Auroxin/picoloader-hw/3d-print/picoloader-pcb-plug-20260901.step

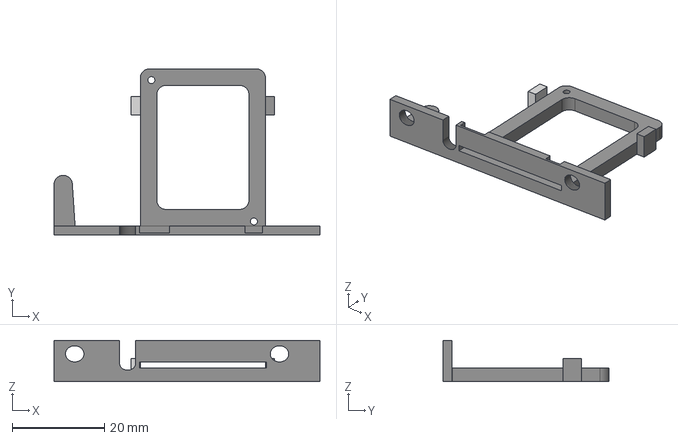
[picture p5: CAD file, 2026-10-19]
3d-print/picoloader-pcb-plug-20260901.step
57.8 x 36.1 x 9.00 mm
