Auroxin/picoloader-hw/3d-print/Fold_KeyV1.2.stl

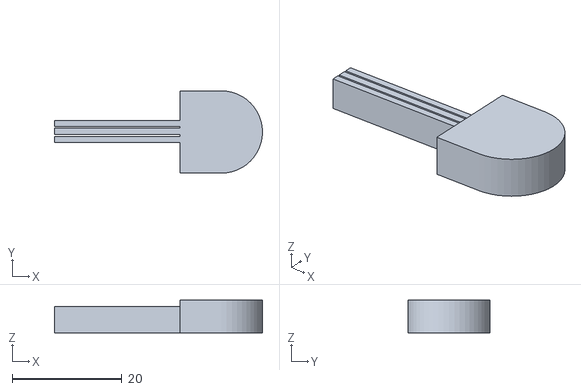
[picture p6: CAD file, 2026-10-19]
3d-print/Fold_KeyV1.2.stl
37.9 x 15.0 x 6.00
