Auroxin/picoloader-hw/3d-print/Drive_PlugV1.1.stl

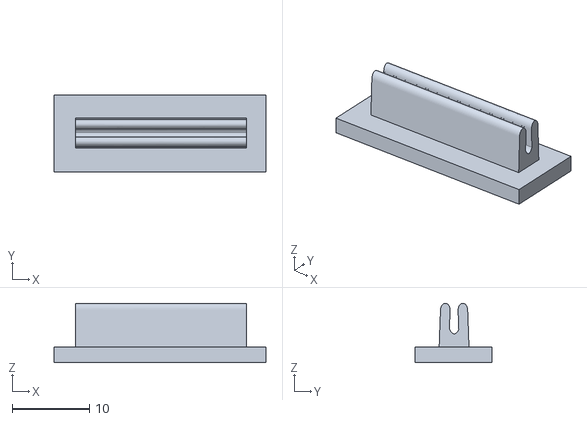
[picture p7: CAD file, 2026-10-19]
3d-print/Drive_PlugV1.1.stl
27.5 x 10.0 x 7.72
