Auroxin/picoloader-hw/hw/v1.1A/picoloader.kicad_pcb

## KiCad design hw/v1.1A/picoloader.kicad_pcb (2026-10-19)

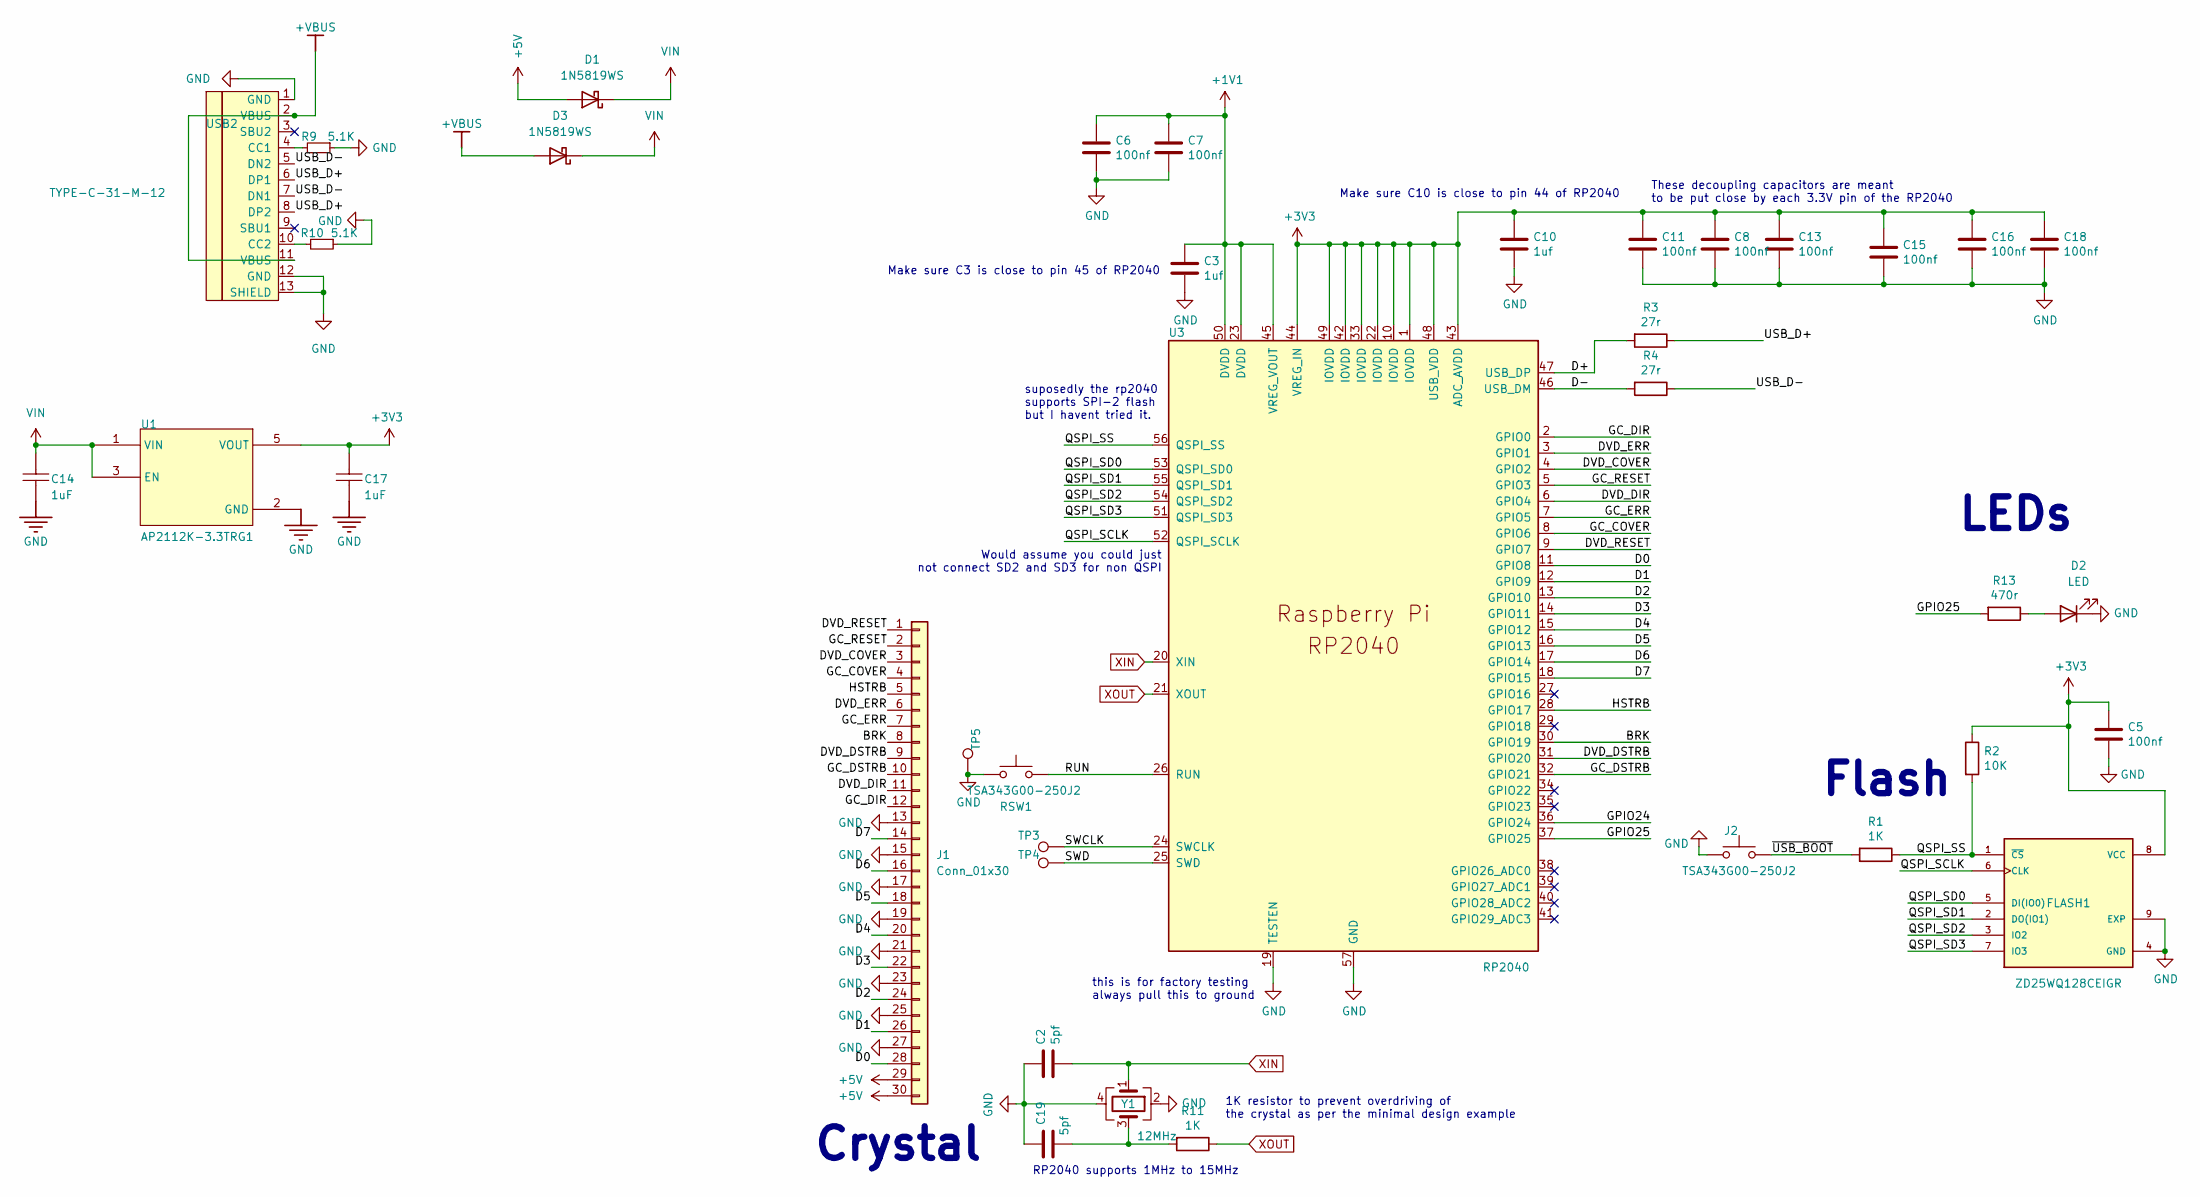
[picture p8: schematic picoloader.kicad_sch]

Parts:
C2, C19: 5pf; C_0402_1005Metric
C3, C10: 1uf; C_0603_1608Metric
C5, C6, C7, C8, C11, C13, C15, C16, C18: 100nf; C_0402_1005Metric
C14, C17: 1uF; C_0603_1608Metric; TOLERANCE 10%; VOLTAGE RATING 25V; MANUFACTURER PART NUMBER C1005X5R1E105K050BC
D1, D3: 1N5819WS; D_SOD-323
D2: LED; LED_0603_1608Metric
FLASH1: ZD25WQ128CEIGR; Winbond_USON-8-1EP_3x2mm_P0.5mm_EP0.2x1.6mm
J1: Conn_01x30; Hirose_FH12-30S-0.5SH_1x30-1MP_P0.50mm_Horizontal
J2: TSA343G00-250J2; SW_Push_SPST_NO_Alps_SKRK
R1, R11: 1K; R_0402_1005Metric
R2: 10K; R_0402_1005Metric
R3, R4: 27r; R_0402_1005Metric
R9, R10: 5.1K; R_0402_1005Metric
R13: 470r; R_0402_1005Metric
RSW1: TSA343G00-250J2; SW_Push_SPST_NO_Alps_SKRK
TP3, TP4, TP5: TestPoint; TestPoint_Pad_D1.0mm
U1: AP2112K-3.3TRG1; SOT-23-5; DROPOUT VOLTAGE 250mV; OUTPUT VOLTAGE 3.3V; MANUFACTURER PART NUMBER AP2112K-3.3TRG1
U3: RP2040; RP2040-QFN-56; LCSC C2040
USB2: TYPE-C-31-M-12; HRO-TYPE-C-31-M-12; LCSC C165948
Y1: 12MHz; Crystal_SMD_3225-4Pin_3.2x2.5mm

Connections:
+1V1: C3.1, C6.1, C7.1, U3.23 (DVDD), U3.45 (VREG_VOUT), U3.50 (DVDD)
+3V3: C5.1, C8.1, C10.1, C11.1, C13.1, C15.1, C16.1, C17.2, C18.1, FLASH1.8 (VCC), R2.1, U1.5 (VOUT), U3.1 (IOVDD), U3.10 (IOVDD), U3.22 (IOVDD), U3.33 (IOVDD), U3.42 (IOVDD), U3.43 (ADC_AVDD), U3.44 (VREG_IN), U3.48 (USB_VDD), U3.49 (IOVDD)
+5V: D1.2 (A), J1.29, J1.30
+VBUS: D3.2 (A), USB2.2 (VBUS), USB2.11 (VBUS)
/BRK: J1.8, U3.30 (GPIO19)
/D0: J1.28, U3.11 (GPIO8)
/D1: J1.26, U3.12 (GPIO9)
/D2: J1.24, U3.13 (GPIO10)
/D3: J1.22, U3.14 (GPIO11)
/D4: J1.20, U3.15 (GPIO12)
/D5: J1.18, U3.16 (GPIO13)
/D6: J1.16, U3.17 (GPIO14)
/D7: J1.14, U3.18 (GPIO15)
/D+: R3.2, U3.47 (USB_DP)
/D-: R4.2, U3.46 (USB_DM)
/DVD_COVER: J1.3, U3.4 (GPIO2)
/DVD_DIR: J1.11, U3.6 (GPIO4)
/DVD_DSTRB: J1.9, U3.31 (GPIO20)
/DVD_ERR: J1.6, U3.3 (GPIO1)
/DVD_RESET: J1.1, U3.9 (GPIO7)
/GC_COVER: J1.4, U3.8 (GPIO6)
/GC_DIR: J1.12, U3.2 (GPIO0)
/GC_DSTRB: J1.10, U3.32 (GPIO21)
/GC_ERR: J1.7, U3.7 (GPIO5)
/GC_RESET: J1.2, U3.5 (GPIO3)
/GPIO24: U3.36 (GPIO24)
/GPIO25: R13.2, U3.37 (GPIO25)
/HSTRB: J1.5, U3.28 (GPIO17)
/QSPI_SCLK: FLASH1.6 (CLK), U3.52 (QSPI_SCLK)
/QSPI_SD0: FLASH1.5 (DI(IO0)), U3.53 (QSPI_SD0)
/QSPI_SD1: FLASH1.2 (DO(IO1)), U3.55 (QSPI_SD1)
/QSPI_SD2: FLASH1.3 (IO2), U3.54 (QSPI_SD2)
/QSPI_SD3: FLASH1.7 (IO3), U3.51 (QSPI_SD3)
/QSPI_SS: FLASH1.1 (~CS), R1.1, R2.2, U3.56 (QSPI_SS)
/RUN: RSW1.2, U3.26 (RUN)
/SWCLK: TP3.1 (1_1), U3.24 (SWCLK)
/SWD: TP4.1 (1_1), U3.25 (SWD)
/USB_D+: R3.1, USB2.6 (DP1), USB2.8 (DP2)
/USB_D-: R4.1, USB2.5 (DN2), USB2.7 (DN1)
/~USB_BOOT: J2.1, R1.2
GND: C2.1, C3.2, C5.2, C6.2, C7.2, C8.2, C10.2, C11.2, C13.2, C14.1, C15.2, C16.2, C17.1, C18.2, C19.1, D2.1 (K), FLASH1.4 (GND), FLASH1.9 (EXP), J1.13, J1.15, J1.17, J1.19, J1.21, J1.23, J1.25, J1.27, J1.MP, J2.2, R9.1, R10.1, RSW1.1, TP5.1 (1_1), U1.2 (GND), U3.19 (TESTEN), U3.57 (GND), USB2.1 (GND), USB2.12 (GND), USB2.13 (SHIELD), Y1.2, Y1.4
unnamed: C19.2, R11.2, Y1.3
unnamed: D2.2 (A), R13.1
unnamed: R9.2, USB2.4 (CC1)
unnamed: R10.2, USB2.10 (CC2)
VIN: C14.2, D1.1 (K), D3.1 (K), U1.1 (VIN), U1.3 (EN)
XIN: C2.2, U3.20 (XIN), Y1.1
XOUT: R11.1, U3.21 (XOUT)

Notes on the sheet:
These decoupling capacitors are meant to be put close by each 3.3V pin of the RP2040
this is for factory testing always pull this to ground
suposedly the rp2040 supports SPI-2 flash but I havent tried it.
1K resistor to prevent overdriving of the crystal as per the minimal design example
LEDs
Crystal
Flash
RP2040 supports 1MHz to 15MHz
Make sure C3 is close to pin 45 of RP2040
Make sure C10 is close to pin 44 of RP2040
Would assume you could just not connect SD2 and SD3 for non QSPI

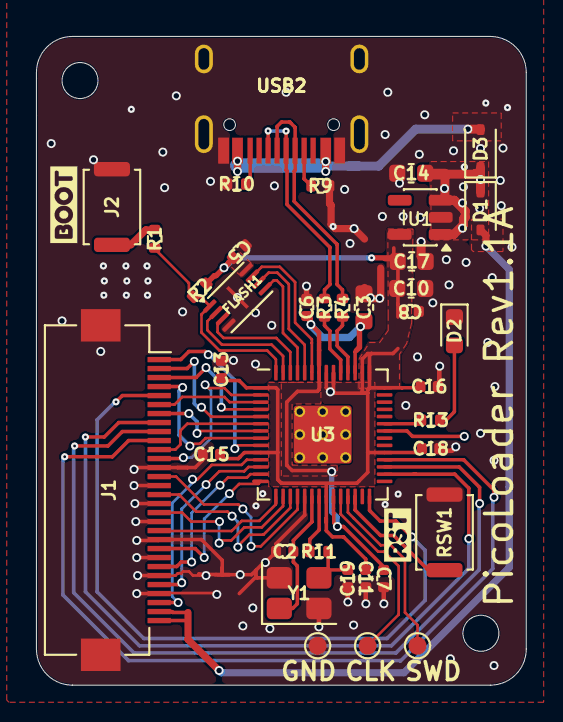
[picture p9: board picoloader.kicad_pcb from above]

Board: 2 copper layers, 27.2 x 36.0 mm, 39 parts (0 on the bottom side), 47 nets.

Other parts of the board:
kibuzzard-6A867A8B: G***; kibuzzard-6A867A8B
kibuzzard-6A867A9B: G***; kibuzzard-6A867A9B
