Auroxin/picoloader-hw/3d-print/README.md

# 3D-printed parts

Mounting hardware required for a solderless installation.

| File | Format | Purpose |
| --- | --- | --- |
| `Drive_PlugV1.1.stl` | STL | Drive-side plug, used when the console runs without a disc drive |
| `Fold_KeyV1.2.stl` | STL | Folding key that creases the flex cable at the correct position |
| `picoloader-pcb-plug-20260901.step` | STEP | Mounting bracket that holds the main board (rev 1.2A and rev 1.1A) |

The STEP file is the editable source for the bracket and can be modified before printing. The
two STL files are ready to slice as they are.
