Auroxin/picoloader-hw/(commit log)

2026-10-19 hw: publish picoloader v1.1, v1.1A, v1.2A and the flex PCB
    - add KiCad 10 projects for the three main-board revisions and the shared 30-pin FFC flex
    - make every project self-contained: fp-lib-table/sym-lib-table resolve through ${KIPRJMOD},
    Library.pretty bundled, packages3D trimmed to the models the PCB actually references
    - add GamecubeConnectors symbol library and the two flex footprints missing from the export
    - normalise the flex 3D model path to ${KICAD10_3DMODEL_DIR}
    - add README, CERN-OHL-P-2.0 LICENSE, .gitignore and .gitattributes
    [Flex.kicad_pcb, Flex.kicad_sch, picoloader.kicad_pcb, picoloader.kicad_sch]
2026-10-19 docs: mark v1.1 discontinued, document the 16 MB version and store links
    - record that v1.1 is discontinued while v1.1A and v1.2A are in production
    - add a version status table with the flash part actually assembled on each revision
    (ZD25WQ16CEIGR / ZD25WQ16DEIGR 2 MB, ZD25WQ128CEIGR 16 MB)
    - add the 16 MB vs 2 MB feature comparison and what the bigger flash enables
    - add the AliExpress purchase links for v1.1A and v1.2A
    - add extras/ with the 16 MB vs 2 MB comparison banner and embed it in the README
2026-10-19 docs: relicense to GPL-2.0, add renders, 3D-print parts and folder READMEs
    - the repository derives from makeo/PicoLoader (GPL-2.0), so LICENSE is now GPL-2.0
    - add NOTICE.md with file-level provenance: two STLs and GamecubeConnectors.kicad_sym
    are byte-identical to upstream, the flex project and DVDCN_FLEX_PADS footprint are modified
    - retitle the README to "PicoLoader - hardware" and credit makeo and silversteel
    - rename "3d print" to 3d-print and document the bracket, drive plug and folding key
    - add PCB renders for v1.1A, v1.2A and the flex, plus a gallery section
    - add a short README.md to every project folder
    [Drive_PlugV1.1.stl, Fold_KeyV1.2.stl, picoloader-pcb-plug-20260901.step]
2026-10-19 build: keep STEP/STL/WRL byte-identical in the repository
    Mark CAD and mesh exchange formats as binary so the line-ending normalisation stops rewriting them; only the .gitattributes rule and the affected model files change.
    [picoloader-pcb-plug-20260901.step]
2026-10-19 docs: move renders into extras/ and credit the PicoLoader community
    - renders now live in extras/ only; the hw/ folders keep no duplicated images
    - fix the relative depth in the folder READMEs (../../extras) and validate every link
    - expand the acknowledgements: makeo, silversteel, the PicoLoader community, swiss-gc and
    the other upstream credits
    - record that the printed bracket fits both rev 1.1A and rev 1.2A
2026-10-19 docs: point to the v1.1A and v1.2A releases for fabrication files
    Both revisions now have a GitHub release with the Gerber/drill package, the BOM and the top-side assembly drawing, so the README links there instead of telling people to generate them.
